OrangeNekoo/HomeFireAlarmSystem/README.md

# 家庭火灾报警系统

基于 TI CC2530（ZB2530 开发板 ×3）的无线传感网课程设计：三个节点组成家庭火灾监测网络，主节点通过 USB 串口桥接 PC，浏览器打开原神风格网页上位机，实时查看温湿度与有害气体数据、下发阈值、触发模拟报警，报警时三端 LED + OLED 联动。

- 平台：CC2530，IAR 8.10，裸机 RF 直连（不用 Z-Stack），自定义帧协议
- 上位机：纯 HTML/CSS/JS + Three.js，`bridge.py` 做串口-WebSocket 桥
- 课程：无线传感网技术课程设计

## 1. 系统架构

```
[温湿度节点 0x02]──RF──┐
                        ├──→ [主节点 0x01] ──USB串口(CSV)──→ [bridge.py] ──WebSocket──→ [网页上位机]
[气体节点 0x03]──RF────┘     LED+OLED报警                    pyserial+WS+静态托管   localhost:8080
```

- RF：250kbps、信道 11（2405MHz，`FREQCTRL=0x0B`）、软件帧内 ID 过滤（`FRMFILT0=0` 关闭硬件过滤，按帧内目的地址字节软件过滤）、广播地址 0xFF；帧尾异或校验防错
- 串口：USART0，115200 8N1，CSV 文本行 + `*校验` 帧尾
- 上位机链路：`bridge.py` HTTP 静态托管 **8080** 端口，WebSocket **8081** 端口
- 报警逻辑集中在主节点：温度 > 阈值（默认 45℃）或气体 ADC 均值 > 阈值（默认 600）即报警，带回差防抖；主节点广播报警状态，终端 OLED 切`火灾警报`（反显+闪烁）+ LED1 闪烁
- 心跳即数据上报（2 秒周期），超 10 秒未收到判定离线；主节点按序号统计丢包率

完整设计见 [docs/superpowers/specs/2026-09-08-home-fire-alarm-design.md](docs/superpowers/specs/2026-09-08-home-fire-alarm-design.md)。

## 2. 硬件清单与接线

| 器件 | 数量 | 用途 |
|---|---|---|
| ZB2530 开发板（CC2530 核心板 + 底板） | 3 | 主节点 / 温湿度节点 / 气体节点 |
| 0.96 寸 OLED（SSD1306，4 线 SPI） | 3 | 三节点显示 |
| DHT11 温湿度传感器 | 1 | 温湿度节点 |
| MQ-2 烟雾/可燃气体模块 | 1 | 气体节点 |
| USB 线（板载 USB 转串口） | 1 | 主节点接 PC |

### 接线表

三节点 OLED 接线统一（4 线软件 SPI，引脚/初始化严格参照 `docs/OLED资料/LCD_OLED示例代码`）：

| OLED 引脚 | CC2530 | 说明 |
|---|---|---|
| SCL（D0） | P1.2 | 软件 SPI 时钟 |
| SDA（D1） | P1.3 | 软件 SPI 数据 |
| RST | P1.7 | 硬件复位（初始化拉低 50ms 再拉高） |
| DC | P0.0 | 命令/数据选通 |
| VCC / GND | 3V3 / GND | |

其余外设：

| 节点 | 外设 | 引脚 | 说明 |
|---|---|---|---|
| 主节点 | 报警 LED | P0.5 输出 | 低电平点亮 |
| 主节点 | 彩蛋按键 | P0.1 输入 | 低电平按下（内部上拉）；按下播放彩蛋动画，再按停止 |
| 主节点 | 串口 | P0.2(RX)/P0.3(TX) | 底板 USB 转串口 |
| 温湿度节点 | DHT11 DATA | P0.7 | 单总线，VCC/GND 按模块标注 |
| 气体节点 | MQ-2 AO | P0.6（AIN6） | ADC 采样 |
| 气体节点 | MQ-2 DO | P0.5 输入 | 开关量（超模块电位器设定值为低） |
| 终端 ×2 | 核心板 LED1 | P1.0 输出 | 报警联动闪烁 |

> **MQ-2 供电安全检查**：若 MQ-2 模块用 5V 供电，AO 输出电压可能超过 CC2530 的 3.3V 耐压。首次使用前先用万用表测清洁空气下的 AO 电压，若超过 3.3V，请在 AO 与 P0.6 之间加 10k/20k 电阻分压。

## 3. 烧录步骤

1. IAR 打开根目录工作区 `HomeFireAlarmSystem.eww`，内含三个工程：`Master`、`TempNode`、`GasNode`。
2. 在 Workspace 下拉框切换工程，分别编译（Project → Rebuild All）。
3. 用 USB 线连接目标板，Project → **Download and Debug**（或 Ctrl+D）烧录，烧完复位运行：
   - `Master` → 主节点（接 PC 的那块）
   - `TempNode` → 温湿度节点
   - `GasNode` → 气体节点

三块板固件独立，互不通用，注意别烧错板子。

> **编码说明**：全部 C 源文件使用 **GBK 编码**（IAR 默认中文编码，注释中文可正常显示）。用 VSCode/Notepad 等外部编辑器查看或修改时请选择 GBK/GB2312 编码打开，**不要用 UTF-8 保存覆盖**，否则 IAR 中中文会变乱码。Python 与网页文件保持 UTF-8 不受影响。

## 4. 启动步骤

1. **MQ-2 预热**：给气体节点上电预热——首次使用 24-48 小时最理想，演示前至少预热 **5 分钟**（否则读数漂移可能误报）。
2. **主节点接 PC**，确认设备管理器里出现串口（如 `COM3`）。
3. **启动桥**（项目自带便携 Python 3.11，不依赖系统 Python；首次使用先装依赖）：

   ```bat
   Python311\python.exe -m pip install pyserial websockets
   Python311\python.exe bridge.py COM3
   ```

   不带参数运行 `bridge.py` 会自动列出可用串口，方便查找 COM 号。
4. **打开上位机**：Edge/Chrome 访问 <http://localhost:8080>。网页自动连接 WebSocket 并自动对时（三块 OLED 的时钟与网页时间一致）。
5. 正常状态：网页显示三张节点卡片、实时温湿度/气体数值与曲线、丢包率；左上串口状态为已连接。若网页连不上硬件，会自动进入**演示模式**（页面有角标提示），重连成功后自动恢复真实数据。

## 5. 答辩演示剧本

前置：三块板烧录最终固件、气体节点预热 ≥5 分钟、主节点 USB 接 PC、`bridge.py` 已启动、网页已打开。

| 步骤 | 操作 | 预期现象 |
|---|---|---|
| 1 正常监测 | 静置观察 | 三卡片在线（金边），数值与曲线滚动，三块 OLED 显示日期时间与数据 |
| 2 阈值报警 | 网页底部"下发阈值"把温度阈值改为 **30**，对着 DHT11 哈气或用热风加热 | 温度超 30 → 三端联动：主节点 LED 闪烁、三块 OLED 切`火灾警报`（反显+闪烁）、网页全屏扩散反应特效；温度回落后**自动解除** |
| 3 模拟报警 | 点网页"模拟报警"按钮 | 三端真实联动，与真实报警效果一致，按钮切换为"解除模拟" |
| 4 解除 | 点"解除模拟"按钮 | 三端恢复正常界面 |
| 5 离线检测 | 拔掉任一终端电源 | 约 10 秒后网页对应卡片变灰"离线"，主节点 OLED 对应数据行显示`离线`；重新上电自动恢复 |
| 6 断线恢复 | 拔主节点 USB（断开串口） | 网页进演示模式并角标提示；重新插回并重启 `bridge.py` 后自动恢复真实数据 |

演示完记得把温度阈值改回默认（45℃）。

### 彩蛋：三端同步动画

主节点 P0.1 接一个低电平按键（另一端接 GND）。在正常监控状态下按下：

1. 主节点去抖确认后经 RF 广播 `cmd=0x04`，并向串口上报 `E,1`；
2. 三块 OLED 同步循环播放 30 帧 64×64 动画（100 ms/帧，居中显示），网页弹出全屏覆盖层播放 30 帧 128×64 动画并循环播放 `web/music/` 下的 MP3；
3. 再次按下 P0.1，三块 OLED 与网页停止播放，OLED 按当前报警状态恢复监控页/报警页，网页复位音乐。

说明：彩蛋与报警状态互相独立，播放期间温湿度/气体采集、上报、离线检测照常；浏览器若拦截自动播放，点击覆盖层中的"启用音乐"按钮即可；网页动画帧位于 `web/easter/128_64/`，固件帧数据由 `tools/extract_easter_frames.py` 从 STM32 工程生成于 `Common/easter_frames.c`（`__code` 存 CODE 区）。

## 6. 常见问题（FAQ）

**串口打开失败 / 被占用**
关掉所有正在占用串口的程序（串口助手、其他 bridge 实例、IAR 的 Terminal I/O），再重新运行 `bridge.py`。

**网页打不开 / 连不上**
- 确认 `bridge.py` 在运行，且用 <http://localhost:8080> 访问（HTTP 8080，WS 8081）；
- 检查 Windows 防火墙是否拦截了 Python，首次运行允许其通过专用网络；
- 端口被占用时换端口或结束占用进程后重启 `bridge.py`。

**RF 收不到数据 / 全部离线**
三块板射频参数必须一致：信道 11（`FREQCTRL=0x0B`，2405MHz）。注意 `FRMFILT0=0` 已关闭硬件帧过滤，收发过滤靠软件按帧内目的 ID 字节判断，SHORT_ADDR 寄存器只是占位——请检查各板天线是否焊好、节点间距不要太远、各 `main.c` 里 `NODE_ID` 与收发帧的 src/dst 配置是否正确（见 `Common/rf.c` 与各 `main.c`）。

**OLED 全黑 / 不亮**
- **RST（P1.7）必须接且初始化时先拉低 50ms 再拉高**——缺失复位沿是屏幕不亮的最常见原因（本次联调实际踩过）；
- 核对四根线：SCL=P1.2、SDA=P1.3、RST=P1.7、DC=P0.0，模块 VCC 接 3V3；
- 电荷泵命令核对：`0x8D 0x14`（开启内部升压，缺失则屏不亮）；

**汉字乱码 / 花屏**
字模为纵向取模、每字 32 字节（上/下半页各 16），来源根目录 `font matrix.txt`；若方向颠倒则整体按位翻转。对照设计规格第 4 节排查。

## 7. 联调记录（待填）

> 本节在三节点硬件联调完成后填写，以下为占位，暂无数据。

- **三节点联调结果**：（硬件联调后填写）
- **MQ-2 阈值标定**：
  - 清洁空气 ADC 均值：（硬件联调后填写）
  - 触发值（酒精/打火机气体逼近时 ADC 均值）：（硬件联调后填写）
  - 最终下发阈值：（硬件联调后填写）
- **发现并修复的问题**：（硬件联调后填写）

## 仓库结构

```
HomeFireAlarmSystem/
├── Master/    主节点 IAR 工程
├── TempNode/  温湿度节点 IAR 工程
├── GasNode/   气体节点 IAR 工程
├── Common/    共享模块（OLED/字库/RF/串口/帧编解码等）
├── Python311/ 便携 Python（不入库，需自备）
├── web/       网页上位机（index.html / main.js / style.css）
├── web/three.min.js  Three.js 渲染库（本地文件，无需 CDN）
├── bridge.py  串口-WebSocket 桥
├── HomeFireAlarmSystem.eww  IAR 工作区
└── docs/      任务书、传感器资料、设计规格
```
