OrangeNekoo/HomeFireAlarmSystem/docs/OLED资料/MinerU_markdown_SPEC_QG-2864TMBEG01_VER_C最新_2097232445432942592.md

# Product Specification

Part Name: OEL Display Module 

Customer Part ID: 

Allvision Part ID: QG-2864TMBEG01 

Ver: C 

## Customer:

Approved by 

From: Allvision technology Inc. 

Approved by 

## Allvision technology Inc.

Http://www.szallvision.com 

## Notes:

1. Please contact Allvision technology Inc.. before assigning your product based on this module specification 2. The information contained herein is presented merely to indicate the characteristics and performance of our products. No responsibility is assumed by Allvision technology Inc. for any intellectual property claims or other problems that may result from application based on the module described herein. 

## Revised History

<table><tr><td>Part Number</td><td>Revision</td><td>Revision Content</td><td>Revised on</td></tr><tr><td>QG-2864TMBEG01</td><td>A</td><td>New</td><td>20130326</td></tr><tr><td></td><td>B</td><td><eq>R_{IREF}=390K</eq>变更为 <eq>R_{IREF}=910K</eq>亮度寄存器(0X81)参数 0XCF 变更为 0X66亮度寄存器(0X81)参数 0X66 变更为 0XCF寄存器(0xD9)的参数 0x1F 变更为 0xF1</td><td>2013052220130529</td></tr></table>

## Contents

Revision History....i
Contents....ii~iii
1. Basic Specifications....1~6
1.1 Display Specifications....1
1.2 Mechanical Specifications....1
1.3 Active Area / Memory Mapping & Pixel Construction....1
1.4 Mechanical Drawing....2
1.5 Pin Definition....3
1.6 Block Diagram....5
1.6.1 Vcc Supplied Externally....5
1.6.2 Vcc Generated by Internal DC/DC Circuit....6
2. Absolute Maximum Ratings....7
3. Optics & Electrical Characteristics....8~18
3.1 Optics Characteristics....8
3.2 DC Characteristics....8
3.3 AC Characteristics....9~18
3.3.1 68XX-Series MPU Parallel Interface Characteristics....9~10
3.3.2 80XX-Series MPU Parallel Interface Characteristics....11~12
3.3.3 Serial Interface Characteristics (4-wire SPI)....13~14
3.3.4 Serial Interface Characteristics (3-wire SPI)....15~16
3.3.5 I²C Interface Characteristics....17~18
4. Functional Specification....19~27
4.1 Commands....19
4.2 Power down and Power up Sequence....19
4.2.1 Power up Sequence....19
4.2.2 Power down Sequence....19
4.3 Reset Circuit....19
4.4 Actual Application Example....20~27
4.4.1 VCC Supplied Externally....20~23
4.4.2 VCC Generated by Internal DC/DC Circuit....24~27
5. Reliability....28
5.1 Contents of Reliability Tests....28
5.2 Failure Check Standard....28
6. Outgoing Quality Control Specifications....29~32
6.1 Environment Required....29
6.2 Sampling Plan....29
6.3 Criteria & Acceptable Quality Level....29~32
6.3.1 Cosmetic Check (Display Off) in Non-Active Area....29~30
6.3.2 Cosmetic Check (Display Off) in Active Area....31
6.3.3 Pattern Check (Display On) in Active Area....32
7. Package Specifications....33
8. Precautions When Using These OEL Display Modules....34~36
8.1 Handling Precautions....34
8.2 Storage Precautions....35
8.3 Designing Precautions....35
8.4 Precautions when disposing of the OEL display modules....35~36 

8.5 Other Precautions.... 36
Warranty.... 36
Notice.... 36 

## 1. Basic Specifications

## 1.1 Display Specifications

1) Display Mode: Passive Matrix 

2) Display Color: Monochrome (Yellow&Blue) 

3) Drive Duty: 

## 1.2 Mechanical Specifications

1) Outline Drawing: According to the annexed outline drawing 

2) Number of Pixels: 128  64 

3) Panel Size: 26.70 × 19.26 × 1.2 (mm) 

4) Active Area: 21.744  11.204 (mm) 

5) Pixel Pitch: 0.17  0.17 (mm) 

6) Pixel Size: 0.154  0.154 (mm) 

7) Weight: 1.54 (g) 

## 1.3 Active Area / Memory Mapping & Pixel Construction





## 1.4 Mechanical Drawing

<table><tr><td>Item</td><td>Date</td><td colspan="8">Remark</td></tr><tr><td>A</td><td>20130326</td><td colspan="8">Original Drawing</td></tr><tr><td>Pin</td><td colspan="9">Symbol</td></tr><tr><td>1</td><td colspan="9">N.C.(GND)</td></tr><tr><td>2</td><td colspan="9">C2P</td></tr><tr><td>3</td><td colspan="9">C2N</td></tr><tr><td>4</td><td colspan="9">C1P</td></tr><tr><td>5</td><td colspan="9">C1N</td></tr><tr><td>6</td><td colspan="9">VBAT</td></tr><tr><td>7</td><td colspan="9">N.C.</td></tr><tr><td>8</td><td colspan="9">VSS</td></tr><tr><td>9</td><td colspan="9">VDD</td></tr><tr><td>10</td><td colspan="9">BS0</td></tr><tr><td>11</td><td colspan="9">BS1</td></tr><tr><td>12</td><td colspan="9">BS2</td></tr><tr><td>13</td><td colspan="9">CS#</td></tr><tr><td>14</td><td colspan="9">RES#</td></tr><tr><td>15</td><td colspan="9">D/C#</td></tr><tr><td>16</td><td colspan="9">R/W#</td></tr><tr><td>17</td><td colspan="9">E/RD#</td></tr><tr><td>18</td><td colspan="9">D0</td></tr><tr><td>19</td><td colspan="9">D1</td></tr><tr><td>20</td><td colspan="9">D2</td></tr><tr><td>21</td><td colspan="9">D3</td></tr><tr><td>22</td><td colspan="9">D4</td></tr><tr><td>23</td><td colspan="9">D5</td></tr><tr><td>24</td><td colspan="9">D6</td></tr><tr><td>25</td><td colspan="9">D7</td></tr><tr><td>26</td><td colspan="9">IREF</td></tr><tr><td>27</td><td colspan="9">VCOMH</td></tr><tr><td>28</td><td colspan="9">VCC</td></tr><tr><td>29</td><td colspan="9">VLSS</td></tr><tr><td>30</td><td colspan="9">N.C.(GND)</td></tr></table>

1.5 Pin Definition

<table><tr><td>Pin Number</td><td>Symbol</td><td>I/O</td><td colspan="4">Function</td></tr><tr><td colspan="7">Power Supply</td></tr><tr><td>9</td><td>VDD</td><td>P</td><td colspan="4">Power Supply for LogicThis is a voltage supply pin. It must be connected to external source.</td></tr><tr><td>8</td><td>VSS</td><td>P</td><td colspan="4">Ground of Logic CircuitThis is a ground pin. It acts as a reference for the logic pins. It must be connected to external ground.</td></tr><tr><td>28</td><td>VCC</td><td>P</td><td colspan="4">Power Supply for OEL PanelThis is the most positive voltage supply pin of the chip. A stabilization capacitor should be connected between this pin and <eq>V_{ss}</eq> when the converter is used. It must be connected to external source when the converter is not used.</td></tr><tr><td>29</td><td>VLSS</td><td>P</td><td colspan="4">Ground of Analog CircuitThis is an analog ground pin. It should be connected to <eq>V_{ss}</eq> externally.</td></tr><tr><td colspan="7">Driver</td></tr><tr><td>26</td><td>IREF</td><td>I</td><td colspan="4">Current Reference for Brightness AdjustmentThis pin is segment current reference pin. A resistor should be connected between this pin and <eq>V_{ss}</eq>. Set the current at 12.5μA maximum.</td></tr><tr><td>27</td><td>VCOMH</td><td>O</td><td colspan="4">Voltage Output High Level for COM SignalThis pin is the input pin for the voltage output high level for COM signals. A capacitor should be connected between this pin and <eq>V_{ss}</eq>.</td></tr><tr><td colspan="7">DC/DC Converter</td></tr><tr><td>6</td><td>VBAT</td><td>P</td><td colspan="4">Power Supply for DC/DC Converter CircuitThis is the power supply pin for the internal buffer of the DC/DC voltage converter. It must be connected to external source when the converter is used. It should be connected to <eq>V_{DD}</eq> when the converter is not used.</td></tr><tr><td>4 / 52 / 3</td><td>C1P / C1NC2P / C2N</td><td>I</td><td colspan="4">Positive Terminal of the Flying Inverting CapacitorNegative Terminal of the Flying Boost CapacitorThe charge-pump capacitors are required between the terminals. They must be floated when the converter is not used.</td></tr><tr><td colspan="7">Interface</td></tr><tr><td rowspan="7">101112</td><td rowspan="7">BS0BS1BS2</td><td rowspan="7">I</td><td colspan="4">Communicating Protocol SelectThese pins are MCU interface selection input. See the following table:</td></tr><tr><td></td><td>BS0</td><td>BS1</td><td>BS2</td></tr><tr><td><eq>I^{2}C</eq></td><td>0</td><td>1</td><td>0</td></tr><tr><td>3-wire SPI</td><td>1</td><td>0</td><td>0</td></tr><tr><td>4-wire SPI</td><td>0</td><td>0</td><td>0</td></tr><tr><td>8-bit 68XX Parallel</td><td>0</td><td>0</td><td>1</td></tr><tr><td>8-bit 80XX Parallel</td><td>0</td><td>1</td><td>1</td></tr><tr><td>14</td><td>RES#</td><td>I</td><td colspan="4">Power Reset for Controller and DriverThis pin is reset signal input. When the pin is low, initialization of the chip is executed. Keep this pin pull high during normal operation.</td></tr><tr><td>13</td><td>CS#</td><td>I</td><td colspan="4">Chip SelectThis pin is the chip select input. The chip is enabled for MCU communication only when CS# is pulled low.</td></tr><tr><td>15</td><td>D/C#</td><td>I</td><td colspan="4">Data/Command ControlThis pin is Data/Command control pin. When the pin is pulled high, the input at D7~D0 is treated as display data. When the pin is pulled low, the input at D7~D0 will be transferred to the command register.When the pin is pulled high and serial interface mode is selected, the data at SDIN will be interpreted as data. When it is pulled low, the data at SDIN will be transferred to the command register. In <eq>I^{2}C</eq> mode, this pin acts as SA0 for slave address selection.For detail relationship to MCU interface signals, please refer to the Timing Characteristics Diagrams.</td></tr><tr><td>17</td><td>E/RD#</td><td>I</td><td colspan="4">Read/Write Enable or ReadThis pin is MCU interface input. When interfacing to a 68XX-series microprocessor, this pin will be used as the Enable (E) signal. Read/write operation is initiated when this pin is pulled high and the CS# is pulled low.When connecting to an 80XX-microprocessor, this pin receives the Read (RD#) signal. Data read operation is initiated when this pin is pulled low and CS# is pulled low.When serial or <eq>I^{2}C</eq> mode is selected, this pin must be connected to <eq>V_{ss}</eq>.</td></tr></table>

1.5 Pin Definition (Continued)

<table><tr><td>Pin Number</td><td>Symbol</td><td>I/O</td><td>Function</td></tr><tr><td colspan="4">Interface (Continued)</td></tr><tr><td>16</td><td>R/W#</td><td>I</td><td>Read/Write Select or WriteThis pin is MCU interface input. When interfacing to a 68XX-series microprocessor, this pin will be used as Read/Write (R/W#) selection input. Pull this pin to &quot;High&quot; for read mode and pull it to &quot;Low&quot; for write mode.When 80XX interface mode is selected, this pin will be the Write (WR#) input.Data write operation is initiated when this pin is pulled low and the CS# is pulled low.When serial or <eq>I^{2}C</eq> mode is selected, this pin must be connected to <eq>V_{SS}</eq>.</td></tr><tr><td>18~25</td><td>D0~D7</td><td>I/O</td><td>Host Data Input/Output BusThese pins are 8-bit bi-directional data bus to be connected to the microprocessor&#x27;s data bus. When serial mode is selected, D1 will be the serial data input SDIN and D0 will be the serial clock input SCLK. When <eq>I^{2}C</eq> mode is selected, D2 &amp; D1 should be tired together and serve as <eq>SDA_{out}</eq> &amp; <eq>SDA_{in}</eq> in application and D0 is the serial clock input SCL.Unused pins must be connected to <eq>V_{SS}</eq> except for D2 in serial mode.</td></tr><tr><td colspan="4">Reserve</td></tr><tr><td>7</td><td>N.C.</td><td>-</td><td>Reserved PinThe N.C. pin between function pins are reserved for compatible and flexible design.</td></tr><tr><td>1, 30</td><td>N.C. (GND)</td><td>-</td><td>Reserved Pin (Supporting Pin)The supporting pins can reduce the influences from stresses on the function pins.These pins must be connected to external ground as the ESD protection circuit.</td></tr></table>

## 1.6 Block Diagram

1.6.1 $\mathsf { V } _ { \mathsf { C C } }$ Supplied Externally 



MCU Interface Selection: BS0, BS1 and BS2 

Pins connected to MCU interface: CS#, RES#, D/C#, R/W#, E/RD#, and D0~D7 

C1, C3: 0.1μF 

C2: 4.7μF 

C4, C5: 4.7μF / 16V X7R 

R1: 910kΩ, R1 = (Voltage at IREF - VSS) / IREF 

1.6.2 $V _ { C C }$ Generated by Internal DC/DC Circuit 



MCU Interface Selection: BS0, BS1 and BS2 

Pins connected to MCU interface: CS#, RES#, D/C#, R/W#, E/RD#, and D0~D7 

C1, C2: 1μF 

C3: $2 . 2 \mu \mathsf { F }$ 

C4: 4.7μF / 16V X7R 

C5, C6: 1μF / 16V X5R 

R1: 910kΩ, R1 = (Voltage at IREF - VSS) / IREF 

## 2. Absolute Maximum Ratings

<table><tr><td>Parameter</td><td>Symbol</td><td>Min</td><td>Max</td><td>Unit</td><td>Notes</td></tr><tr><td>Supply Voltage for Logic</td><td><eq>V_{DD}</eq></td><td>-0.3</td><td>4</td><td>V</td><td>1, 2</td></tr><tr><td>Supply Voltage for Display</td><td><eq>V_{CC}</eq></td><td>0</td><td>16</td><td>V</td><td>1, 2</td></tr><tr><td>Supply Voltage for DC/DC</td><td><eq>V_{BAT}</eq></td><td>-0.3</td><td>5</td><td>V</td><td>1, 2</td></tr><tr><td>Operating Temperature</td><td><eq>T_{OP}</eq></td><td>-40</td><td>85</td><td>°C</td><td></td></tr><tr><td>Storage Temperature</td><td><eq>T_{STG}</eq></td><td>-40</td><td>85</td><td>°C</td><td>3</td></tr><tr><td>Life Time (120 cd/m2)</td><td></td><td>10,000</td><td>-</td><td>hour</td><td>4</td></tr><tr><td>Life Time (80 cd/m2)</td><td></td><td>30,000</td><td>-</td><td>hour</td><td>4</td></tr><tr><td>Life Time (60 cd/m2)</td><td></td><td>50,000</td><td>-</td><td>hour</td><td>4</td></tr></table>

Note 1: All the above voltages are on the basis of $\ " \mathrm { V } _ { \mathsf { S S } } = 0 \mathsf { V } ^ { \prime \prime } .$ 

Note 2: When this module is used beyond the above absolute maximum ratings, permanent breakage of the module may occur. Also, for normal operations, it is desirable to use this module under the conditions according to Section 3. “Optics & Electrical Characteristics”. If this module is used beyond these conditions, malfunctioning of the module can occur and the reliability of the module may deteriorate. 

Note 3: The defined temperature ranges do not include the polarizer. The maximum withstood temperature of the polarizer should be $8 0 \%$ 

Note 4: $\mathsf { V } _ { \mathsf { C C } } = 1 2 . 0 \mathsf { V } , \mathsf { T } _ { \mathsf { a } } = 2 5 ^ { \circ } \mathsf { C } ,$ 50% Checkerboard. 

Software configuration follows Section 4.4 Initialization. 

End of lifetime is specified as 50% of initial brightness reached. The average operating lifetime at room temperature is estimated by the accelerated operation at high temperature conditions. 

## 3. Optics & Electrical Characteristics

## 3.1 Optics Characteristics

<table><tr><td>Characteristics</td><td>Symbol</td><td>Conditions</td><td>Min</td><td>Typ</td><td>Max</td><td>Unit</td></tr><tr><td>Brightness(<eq>V_{CC}</eq> Supplied Externally)</td><td><eq>L_{br}</eq></td><td>Note 5</td><td>150</td><td>-</td><td>-</td><td><eq>cd/m^{2}</eq></td></tr><tr><td>Brightness(<eq>V_{CC}</eq> Generated by Internal DC/DC)</td><td><eq>L_{br}</eq></td><td>Note 6</td><td>150</td><td>180</td><td>-</td><td><eq>cd/m^{2}</eq></td></tr><tr><td>C.I.E. (Blue)</td><td>(x)(y)</td><td>C.I.E. 1931</td><td>0.100.20</td><td>0.140.24</td><td>0.180.28</td><td></td></tr><tr><td>C.I.E. (Yellow)</td><td>(x)(y)</td><td>C.I.E. 1931</td><td>0.430.45</td><td>0.470.49</td><td>0.510.53</td><td></td></tr><tr><td>Dark Room Contrast</td><td>CR</td><td></td><td>-</td><td>2000:1</td><td>-</td><td></td></tr><tr><td>Viewing Angle</td><td></td><td></td><td>-</td><td>Free</td><td>-</td><td>degree</td></tr></table>

* Optical measurement taken at $\mathsf { V } _ { \mathsf { D D } } = 2 . 8 \mathsf { V } ,$ $\mathsf { V } _ { \mathsf { C C } } = 1 2 \mathsf { V }$ & 7<sub>.</sub>25V. 

Software configuration follows Section 4.4 Initialization. 

## 3.2 DC Characteristics

<table><tr><td>Characteristics</td><td>Symbol</td><td>Conditions</td><td>Min</td><td>Typ</td><td>Max</td><td>Unit</td></tr><tr><td>Supply Voltage for Logic</td><td><eq>V_{DD}</eq></td><td></td><td>1.65</td><td>2.8</td><td>3.3</td><td>V</td></tr><tr><td>Supply Voltage for Display (Supplied Externally)</td><td><eq>V_{CC}</eq></td><td>Note 5 (Internal DC/DC Disable)</td><td>11.5</td><td>12.0</td><td>12.5</td><td>V</td></tr><tr><td>Supply Voltage for DC/DC</td><td><eq>V_{BAT}</eq></td><td>Internal DC/DC Enable</td><td>3.5</td><td>-</td><td>4.2</td><td>V</td></tr><tr><td>Supply Voltage for Display (Generated by Internal DC/DC)</td><td><eq>V_{CC}</eq></td><td>Note 6 (Internal DC/DC Enable)</td><td>7.0</td><td>-</td><td>7.5</td><td>V</td></tr><tr><td>High Level Input</td><td><eq>V_{IH}</eq></td><td><eq>I_{OUT} = 100μA, 3.3MHz</eq></td><td><eq>0.8×V_{DD}</eq></td><td>-</td><td><eq>V_{DD}</eq></td><td>V</td></tr><tr><td>Low Level Input</td><td><eq>V_{IL}</eq></td><td><eq>I_{OUT} = 100μA, 3.3MHz</eq></td><td>0</td><td>-</td><td><eq>0.2×V_{DD}</eq></td><td>V</td></tr><tr><td>High Level Output</td><td><eq>V_{OH}</eq></td><td><eq>I_{OUT} = 100μA, 3.3MHz</eq></td><td><eq>0.9×V_{DD}</eq></td><td>-</td><td><eq>V_{DD}</eq></td><td>V</td></tr><tr><td>Low Level Output</td><td><eq>V_{OL}</eq></td><td><eq>I_{OUT} = 100μA, 3.3MHz</eq></td><td>0</td><td>-</td><td><eq>0.1×V_{DD}</eq></td><td>V</td></tr><tr><td>Operating Current for <eq>V_{DD}</eq></td><td><eq>I_{DD}</eq></td><td></td><td>-</td><td>180</td><td>300</td><td>μA</td></tr><tr><td>Operating Current for <eq>V_{CC}</eq>(<eq>V_{CC}</eq> Supplied Externally)</td><td><eq>I_{CC}</eq></td><td>Note 7</td><td>-</td><td>9</td><td>15</td><td>mA</td></tr><tr><td>Operating Current for <eq>V_{BAT}</eq>(<eq>V_{CC}</eq> Generated by Internal DC/DC)</td><td><eq>I_{BAT}</eq></td><td>Note 8</td><td>-</td><td>25.6</td><td>32.0</td><td>mA</td></tr><tr><td>Sleep Mode Current for <eq>V_{DD}</eq></td><td><eq>I_{DD, SLEEP}</eq></td><td></td><td>-</td><td>1</td><td>5</td><td>μA</td></tr><tr><td>Sleep Mode Current for <eq>V_{CC}</eq></td><td><eq>I_{CC, SLEEP}</eq></td><td></td><td>-</td><td>2</td><td>10</td><td>μA</td></tr></table>

Note 5 & 6: Brightness $( \mathsf { L } _ { \mathsf { b r } } )$ and Supply Voltage for Display $( \mathsf { V } _ { \mathsf { C C } } )$ are subject to the change of the pane characteristics and the customer’s request. 

Note 7: V<sub>DD</sub> = 2.8V, V<sub>CC</sub> = 12V, 100% Display Area Turn on. 

Note 8: Vpp = 2.8V, Vcc = 7.25V, 100% Display Area Turn on 

* Software configuration follows Section 4.4 Initialization. 

## 3.3 AC Characteristics

3.3.1.1 68XX-Series MPU Parallel Interface Timing Characteristics:

<table><tr><td>Symbol</td><td>Description</td><td>Min</td><td>Max</td><td>Unit</td></tr><tr><td><eq>t_{cycle}</eq></td><td>Clock Cycle Time</td><td>300</td><td>-</td><td>ns</td></tr><tr><td><eq>t_{AS}</eq></td><td>Address Setup Time</td><td>5</td><td>-</td><td>ns</td></tr><tr><td><eq>t_{AH}</eq></td><td>Address Hold Time</td><td>0</td><td>-</td><td>ns</td></tr><tr><td><eq>t_{DSW}</eq></td><td>Write Data Setup Time</td><td>40</td><td>-</td><td>ns</td></tr><tr><td><eq>t_{DHW}</eq></td><td>Write Data Hold Time</td><td>7</td><td>-</td><td>ns</td></tr><tr><td><eq>t_{DHR}</eq></td><td>Read Data Hold Time</td><td>20</td><td>-</td><td>ns</td></tr><tr><td><eq>t_{OH}</eq></td><td>Output Disable Time</td><td>-</td><td>70</td><td>ns</td></tr><tr><td><eq>t_{ACC}</eq></td><td>Access Time</td><td>-</td><td>140</td><td>ns</td></tr><tr><td rowspan="2"><eq>PW_{CSL}</eq></td><td>Chip Select Low Pulse Width (Read)</td><td>120</td><td rowspan="2">-</td><td rowspan="2">ns</td></tr><tr><td>Chip Select Low Pulse width (Write)</td><td>60</td></tr><tr><td rowspan="2"><eq>PW_{CSH}</eq></td><td>Chip Select High Pulse Width (Read)</td><td>60</td><td rowspan="2">-</td><td rowspan="2">ns</td></tr><tr><td>Chip Select High Pulse Width (Write)</td><td>60</td></tr><tr><td><eq>t_{R}</eq></td><td>Rise Time</td><td>-</td><td>40</td><td>ns</td></tr><tr><td><eq>t_{F}</eq></td><td>Fall Time</td><td>-</td><td>40</td><td>ns</td></tr></table>

* (V<sub>DD</sub> - V<sub>SS</sub> = 1.65V to 3.3V, T<sub>a</sub> = 25°C) 



## 3.3.1.2 68XX-Series MPU Parallel Interface with Internal Charge Pump



Recommended Components: 

C1, C2: 1μF / 16V, X5R 

C3: 2.2μF 

C4: 4.7μF / 16V, X7R 

C5, C6: 1μF 

R1: 910kΩ, R1 = (Voltage at IREF - VSS) / IREF 

R2, R3: 47kΩ 

Q1: FDN338P 

Q2: FDN335N 

Notes: 

VDD: 1.65~3.3V, it should be equal to MPU I/O voltage. 

Vin: 3.5~4.2V 

* VBAT will be connected to VDD when VCC be connected to external source (12V), R1 should be replaced as 910 kΩ. 

3.3.2.1 80XX-Series MPU Parallel Interface Timing Characteristics:

<table><tr><td>Symbol</td><td>Description</td><td>Min</td><td>Max</td><td>Unit</td></tr><tr><td><eq>t_{cycle}</eq></td><td>Clock Cycle Time</td><td>300</td><td>-</td><td>ns</td></tr><tr><td><eq>t_{AS}</eq></td><td>Address Setup Time</td><td>10</td><td>-</td><td>ns</td></tr><tr><td><eq>t_{AH}</eq></td><td>Address Hold Time</td><td>0</td><td>-</td><td>ns</td></tr><tr><td><eq>t_{DSW}</eq></td><td>Write Data Setup Time</td><td>40</td><td>-</td><td>ns</td></tr><tr><td><eq>t_{DHW}</eq></td><td>Write Data Hold Time</td><td>7</td><td>-</td><td>ns</td></tr><tr><td><eq>t_{DHR}</eq></td><td>Read Data Hold Time</td><td>20</td><td>-</td><td>ns</td></tr><tr><td><eq>t_{OH}</eq></td><td>Output Disable Time</td><td>-</td><td>70</td><td>ns</td></tr><tr><td><eq>t_{ACC}</eq></td><td>Access Time</td><td>-</td><td>140</td><td>ns</td></tr><tr><td><eq>t_{PWLR}</eq></td><td>Read Low Time</td><td>120</td><td>-</td><td>ns</td></tr><tr><td><eq>t_{PWLW}</eq></td><td>Write Low Time</td><td>60</td><td>-</td><td>ns</td></tr><tr><td><eq>t_{PWHR}</eq></td><td>Read High Time</td><td>60</td><td>-</td><td>ns</td></tr><tr><td><eq>t_{PWHW}</eq></td><td>Write High Time</td><td>60</td><td>-</td><td>ns</td></tr><tr><td><eq>t_{CS}</eq></td><td>Chip Select Setup Time</td><td>0</td><td>-</td><td>ns</td></tr><tr><td><eq>t_{CSH}</eq></td><td>Chip Select Hold Time to Read Signal</td><td>0</td><td>-</td><td>ns</td></tr><tr><td><eq>t_{CSF}</eq></td><td>Chip Select Hold Time</td><td>20</td><td>-</td><td>ns</td></tr><tr><td><eq>t_{R}</eq></td><td>Rise Time</td><td>-</td><td>40</td><td>ns</td></tr><tr><td><eq>t_{F}</eq></td><td>Fall Time</td><td>-</td><td>40</td><td>ns</td></tr></table>

* (V<sub>DD</sub> - V<sub>SS</sub> = 1.65V to 3.3V, T<sub>a</sub> = 25°C) 



( Read Timin<sub>g</sub> )



( WriteTimin<sub>g</sub> )

## 3.3.2.2 80XX-Series MPU Parallel Interface with Internal Charge Pump

80xx parallel interface



Recommended Components: 

C1, C2: 1μF / 16V, X5R 

C3: 2.2μF 

C4: 4.7μF / 16V, X7R 

C5, C6: 1μF 

R1: 910kΩ, R1 = (Voltage at IREF - VSS) / IREF 

R2, R3: 47kΩ 

Q1: FDN338P 

Q2: FDN335N 

Notes: 

VDD: 1.65~3.3V, it should be equal to MPU I/O voltage. 

Vin: 3.5~4.2V 

* VBAT will be connected to VDD when VCC be connected to external source (12V), R1 should be replaced as 910 kΩ. 

3.3.3.1 Serial Interface Timing Characteristics: (4-wire SPI)

<table><tr><td>Symbol</td><td>Description</td><td>Min</td><td>Max</td><td>Unit</td></tr><tr><td><eq>t_{cycle}</eq></td><td>Clock Cycle Time</td><td>100</td><td>-</td><td>ns</td></tr><tr><td><eq>t_{AS}</eq></td><td>Address Setup Time</td><td>15</td><td>-</td><td>ns</td></tr><tr><td><eq>t_{AH}</eq></td><td>Address Hold Time</td><td>15</td><td>-</td><td>ns</td></tr><tr><td><eq>t_{CSS}</eq></td><td>Chip Select Setup Time</td><td>20</td><td>-</td><td>ns</td></tr><tr><td><eq>t_{CSH}</eq></td><td>Chip Select Hold Time</td><td>10</td><td>-</td><td>ns</td></tr><tr><td><eq>t_{DSW}</eq></td><td>Write Data Setup Time</td><td>15</td><td>-</td><td>ns</td></tr><tr><td><eq>t_{DHW}</eq></td><td>Write Data Hold Time</td><td>15</td><td>-</td><td>ns</td></tr><tr><td><eq>t_{CLKL}</eq></td><td>Clock Low Time</td><td>20</td><td>-</td><td>ns</td></tr><tr><td><eq>t_{CLKH}</eq></td><td>Clock High Time</td><td>20</td><td>-</td><td>ns</td></tr><tr><td><eq>t_{R}</eq></td><td>Rise Time</td><td>-</td><td>40</td><td>ns</td></tr><tr><td><eq>t_{F}</eq></td><td>Fall Time</td><td>-</td><td>40</td><td>ns</td></tr></table>

* (V<sub>DD</sub> - V<sub>SS</sub> = 1.65V to 3.3V, T<sub>a</sub> = 25°C) 





## 3.3.3.2 4-wire Serial Interface with Internal Charge Pump

4-w ire serial interface



Recommended Components: 

C1, C2: 1μF / 16V, X5R 

C3: 2.2μF 

C4: 4.7μF / 16V, X7R 

C5, C6: 1μF 

R1: 910kΩ, R1 = (Voltage at IREF - VSS) / IREF 

R2, R3: 47kΩ 

R4, R5: 4.7kΩ 

Q1: FDN338P 

Q2: FDN335N 

Notes: 

VDD: 1.65~3.3V, it should be equal to MPU I/O voltage. 

Vin: 3.5~4.2V 

* VBAT will be connected to VDD when VCC be connected to external source (12V), R1 should be replaced as 910 kΩ. 

3.3.4.1 Serial Interface Timing Characteristics: (3-wire SPI)

<table><tr><td>Symbol</td><td>Description</td><td>Min</td><td>Max</td><td>Unit</td></tr><tr><td><eq>t_{cycle}</eq></td><td>Clock Cycle Time</td><td>100</td><td>-</td><td>ns</td></tr><tr><td><eq>t_{CSS}</eq></td><td>Chip Select Setup Time</td><td>20</td><td>-</td><td>ns</td></tr><tr><td><eq>t_{CSH}</eq></td><td>Chip Select Hold Time</td><td>10</td><td>-</td><td>ns</td></tr><tr><td><eq>t_{DSW}</eq></td><td>Write Data Setup Time</td><td>15</td><td>-</td><td>ns</td></tr><tr><td><eq>t_{DHW}</eq></td><td>Write Data Hold Time</td><td>15</td><td>-</td><td>ns</td></tr><tr><td><eq>t_{CLKL}</eq></td><td>Clock Low Time</td><td>20</td><td>-</td><td>ns</td></tr><tr><td><eq>t_{CLKH}</eq></td><td>Clock High Time</td><td>20</td><td>-</td><td>ns</td></tr><tr><td><eq>t_{R}</eq></td><td>Rise Time</td><td>-</td><td>40</td><td>ns</td></tr><tr><td><eq>t_{F}</eq></td><td>Fall Time</td><td>-</td><td>40</td><td>ns</td></tr></table>

* (V<sub>DD</sub> - V<sub>SS</sub> = 1.65V to 3.3V, T<sub>a</sub> = 25°C) 





## 3.3.4.2 3-wire Serial Interface with Internal Charge Pump



Recommended Components: 

C1, C2: 1μF / 16V, X5R 

C3: 2.2μF 

C4: 4.7μF / 16V, X7R 

C5, C6: 1μF 

R1: 910kΩ, R1 = (Voltage at IREF - VSS) / IREF 

R2, R3: 47kΩ 

R4, R5: 4.7kΩ 

Q1: FDN338P 

Q2: FDN335N 

Notes: 

VDD: 1.65~3.3V, it should be equal to MPU I/O voltage. 

Vin: 3.5~4.2V 

* VBAT will be connected to VDD when VCC be connected to external source (12V), R1 should be replaced as 910 kΩ. 

## 3.3.5.1 $\bar { \mathsf { I } } ^ { 2 } \mathsf { C }$ Interface Timing Characteristics:

<table><tr><td>Symbol</td><td>Description</td><td>Min</td><td>Max</td><td>Unit</td></tr><tr><td><eq>t_{cycle}</eq></td><td>Clock Cycle Time</td><td>2.5</td><td>-</td><td>μs</td></tr><tr><td><eq>t_{HSTART}</eq></td><td>Start Condition Hold Time</td><td>0.6</td><td>-</td><td>μs</td></tr><tr><td rowspan="2"><eq>t_{HD}</eq></td><td>Data Hold Time (for &quot;SDAOUT&quot; Pin)</td><td>0</td><td rowspan="2">-</td><td rowspan="2">ns</td></tr><tr><td>Data Hold Time (for &quot;SDAIN&quot; Pin)</td><td>300</td></tr><tr><td><eq>t_{SD}</eq></td><td>Data Setup Time</td><td>100</td><td>-</td><td>ns</td></tr><tr><td><eq>t_{SSTART}</eq></td><td>Start Condition Setup Time(Only relevant for a repeated Start condition)</td><td>0.6</td><td>-</td><td>μs</td></tr><tr><td><eq>t_{SSTOP}</eq></td><td>Stop Condition Setup Time</td><td>0.6</td><td>-</td><td>μs</td></tr><tr><td><eq>t_{R}</eq></td><td>Rise Time for Data and Clock Pin</td><td></td><td>300</td><td>ns</td></tr><tr><td><eq>t_{F}</eq></td><td>Fall Time for Data and Clock Pin</td><td></td><td>300</td><td>ns</td></tr><tr><td><eq>t_{IDLE}</eq></td><td>Idle Time before a New Transmission can Start</td><td>1.3</td><td>-</td><td>μs</td></tr></table>

* (V<sub>DD</sub> - V<sub>SS</sub> = 1.65V to 3.3V, T<sub>a</sub> = 25°C) 



I2 C in te rfa c e 

## 3.3.5.2 I<sup>2</sup>C Interface with Internal Charge Pump



## Recommended Components:

C1, C2: 1μF / 16V, X5R 

C3: 2.2μF 

C4: 4.7μF / 16V, X7R 

C5, C6: 1μF 

R1: 910kΩ, R1 = (Voltage at IREF - VSS) / IREF 

R2, R3: 47kΩ 

R4, R5: 4.7kΩ 

Q1: FDN338P 

Q2: FDN335N 

Notes: 

VDD: 1.65~3.3V, it should be equal to MPU I/O voltage. 

Vin: 3.5~4.2V 

The $\bar { \mathsf { I } } ^ { 2 } \mathsf { C }$ slave address is 0111100b’. If the customer ties D/C# (pin 15) to VDD, the $\bar { \mathsf { I } } ^ { 2 } \mathsf { C }$ slave address will be 0111101b’. 

* VBAT will be connected to VDD when VCC be connected to external source (12V), R1 should be replaced as 910 kΩ. 

## 4.Functional Specification

## 4.1 Commands

Refer to the Technical Manual for the SSD1306 

## 4.2 Power down and Power up Sequence

To protect OEL panel and extend the panel life time, the driver IC power up/down routine should include a delay period between high voltage and low voltage power sources during turn on/off. It gives the OEL panel enough time to complete the action of charge and discharge before/after the operation. 

## 4.2.1 Power up Sequence:

1. Power up $\mathsf { V } _ { \mathsf { D D } }$ 

2. Send Display off command 

3. Initialization 

4. Clear Screen 

5. Power up $\mathsf { V } _ { \mathsf { C C } } / \mathsf { V } _ { \mathsf { B A T } }$ 

6. Delay 100ms 

(When $\mathsf { V } _ { \mathsf { C C } }$ is stable) 

7. Send Display on command 



## 4.2.2 Power down Sequence:

1. Send Display off command 

2. Power down $\mathsf { V } _ { \mathsf { C C } } / \mathsf { V } _ { \mathsf { B A T } }$ 

3. Delay 100ms (When $\mathsf { V } _ { \mathsf { C C } } \ / \ \mathsf { V } _ { \mathsf { B A T } }$ is reach 0 and panel is completely discharges) 

4. Power down $\mathsf { V } _ { \mathsf { D D } }$ 



## Note 13:

1) Since an ESD protection circuit is connected between $\mathsf { V } _ { \mathsf { D D } }$ and $\mathsf { V } _ { \mathsf { C C } }$ inside the driver IC, $\mathsf { V } _ { \mathsf { C C } }$ becomes lower than $\mathsf { V } _ { \mathsf { D D } }$ whenever $\mathsf { V } _ { \mathsf { D D } }$ is ON and $\mathsf { V } _ { \mathsf { C C } }$ is OFF. 

2) $\mathsf { V } _ { \mathsf { C C } } / \mathsf { V } _ { \mathsf { B A T } }$ should be kept float (disable) when it is OFF. 

3) Power Pins $( \mathsf { V } _ { \mathsf { D D } } , \mathsf { V } _ { \mathsf { C C } } , \mathsf { V } _ { \mathsf { B A T } } )$ can never be pulled to ground under any circumstance. 

4) $\mathsf { V } _ { \mathsf { D D } }$ should not be power down before $\mathsf { V } _ { \mathsf { C C } } / \mathsf { V } _ { \mathsf { B A T } }$ power down. 

## 4.3 Reset Circuit

When RES# input is low, the chip is initialized with the following status: 

1. Display is OFF 

2. 12864 Display Mode 

3. Normal segment and display data column and row address mapping (SEG0 mapped to column address 00h and COM0 mapped to row address 00h) 

4. Shift register data clear in serial interface 

5. Display start line is set at display RAM address 0 

6. Column address counter is set at 0 

7. Normal scan direction of the COM outputs 

8. Contrast control register is set at 7Fh 

9. Normal display mode (Equivalent to A4h command) 

## 4.4 Actual Application Example

Command usage and explanation of an actual example 

## 4.4.1 V<sub>CC</sub> Supplied Externally

<Power up Sequence> 



If the noise is accidentally occurred at the displaying window during the operation, please reset the display in order to recover the display function.

<Power down Sequence> 

<Entering Sleep Mode> 

<Exiting Sleep Mode> 

write_i(0x00); /*set lower column address*/ write_i(0x10); /*set higher column address*/ 

write_i(0x40); /*set display start line*/ 

write_i(0xB0); /*set page address*/ 

```c
write_i(0x81);    /*contract control*/
write_i(0xcf);    /*128*/

write_i(0xA1);    /*set segment remap*/

write_i(0xA6);    /*normal / reverse*/

write_i(0xA8);    /*multiplex ratio*/
write_i(0x3F);    /*duty = 1/64*/

write_i(0xC8);    /*Com scan direction*/

write_i(0xD3);    /*set display offset*/
write_i(0x00);

write_i(0xD5);    /*set osc division*/
write_i(0x80);

write_i(0xD9);    /*set pre-charge period*/

write_i(0xf1);

write_i(0xDA);    /*set COM pins*/

write_i(0x12);

write_i(0xdb);    /*set vcomh*/

write_i(0x40);

write_i(0x8d);    /*set charge pump disable*/

write_i(0x10);

write_i(0xAF);    /*display ON*/

void write_i(unsigned char ins)
{
    DC=0;
    CS=0;
    WR=1;
    P1=ins;    /*inst*/
    WR=0;
    WR=1;
    CS=1;
}

void write_d(unsigned char dat)
{
    DC=1; 
```

$$
\begin{array}{l} \text {CS = 0;} \\ \text {WR = 1;} \\ \text {P1 = dat;} \\ \text {WR = 0;} \\ \text {WR = 1;} \\ \text {CS = 1;} \\ \} \end{array} \quad / * \text {data*}
$$

```lisp
void delay(unsigned int i)
{
    while(i>0)
    {
    i--;
    }
} 
```

## 4.4.2 Vcc Generated by Internal DC/DC Circuit

## <Power up Sequence>



If the noise is accidentally occurred at the displaying window during the operation, please reset the display in order to recover the display function.

<Power down Sequence> 

<Entering Sleep Mode> 



<Exiting Sleep Mode> 

```c
Internal setting (Charge pump)
{
    RES=1;
    delay(1000);
    RES=0;
    delay(1000);
    RES=1;
    delay(1000);
write_i(0xAE);    /*display off*/
write_i(0x00);    /*set lower column address*/
write_i(0x10);    /*set higher column address*/ 
```

```txt
write_i(0x40);    /*set display start line*/
write_i(0xB0);    /*set page address*/
write_i(0x81);    /*contract control*/
write_i(0xcf);    /*128*/
write_i(0xA1);    /*set segment remap*/
write_i(0xA6);    /*normal / reverse*/
write_i(0xA8);    /*multiplex ratio*/
write_i(0x3F);    /*duty = 1/64*/
write_i(0xC8);    /*Com scan direction*/
write_i(0xD3);    /*set display offset*/
write_i(0x00);
write_i(0xD5);    /*set osc division*/
write_i(0x80);
write_i(0xD9);    /*set pre-charge period*/
write_i(0xf1);
write_i(0xDA);    /*set COM pins*/
write_i(0x12);
write_i(0xdb);    /*set vcomh*/
write_i(0x40);
write_i(0x8d);    /*set charge pump enable*/
write_i(0x14);
write_i(0xAF);    /*display ON*/
}
id write_i(unsigned char ins)
DC=0;
CS=0;
WR=1;
P1=ins;    /*inst*/
WR=0;
WR=1;
CS=1; 
```

void write_d(unsigned char dat) 

```txt
{
    DC=1;
    CS=0;
    WR=1;
    P1=dat;    /*data*/
    WR=0;
    WR=1;
    CS=1;
} 
```

```lisp
void delay(unsigned int i)
{
    while(i>0)
    {
    i--;
    }
} 
```

## 5. Reliability

## 5.1 Contents of Reliability Tests

<table><tr><td>Item</td><td>Conditions</td><td>Criteria</td></tr><tr><td>High Temperature Operation</td><td>70°C, 240 hrs</td><td rowspan="6">The operational functions work.</td></tr><tr><td>Low Temperature Operation</td><td>-40°C, 240 hrs</td></tr><tr><td>High Temperature Storage</td><td>85°C, 240 hrs</td></tr><tr><td>Low Temperature Storage</td><td>-40°C, 240 hrs</td></tr><tr><td>High Temperature/Humidity Operation</td><td>60°C, 90% RH, 120 hrs</td></tr><tr><td>Thermal Shock</td><td>-40°C ⇔ 85°C, 24 cycles60 mins dwell</td></tr></table>

* The samples used for the above tests do not include polarizer. 

* No moisture condensation is observed during tests. 

## 5.2 Failure Check Standard

After the completion of the described reliability test, the samples were left at room temperature for 2 hrs prior to conducting the failure test at $2 3 { \pm } 5 ^ { \circ } \mathsf C ;$ 5515% RH. 

## 6. Outgoing Quality Control Specifications

## 6.1 Environment Required

Customer’s test & measurement are required to be conducted under the following conditions: 

Temperature: 

Humidity: 

23 ± 5℃ 

55  15% RH 

Fluorescent Lamp: 

30W 

Distance between the Panel & Lamp: 

≥ 50cm 

Distance between the Panel & Eyes of the Inspector: ≥ 30cm 

Finger glove (or finger cover) must be worn by the inspector. 

Inspection table or jig must be anti-electrostatic. 

## 6.2 Sampling Plan

Level II, Normal Inspection, Single Sampling, MIL-STD-105E 

## 6.3 Criteria & Acceptable Quality Level

<table><tr><td>Partition</td><td>AQL</td><td>Definition</td></tr><tr><td>Major</td><td>0.65</td><td>Defects in Pattern Check (Display On)</td></tr><tr><td>Minor</td><td>1.0</td><td>Defects in Cosmetic Check (Display Off)</td></tr></table>

## 6.3.1 Cosmetic Check (Display Off) in Non-Active Area

<table><tr><td>Check Item</td><td>Classification</td><td>Criteria</td></tr><tr><td>Panel General Chipping</td><td>Minor</td><td>X &gt; 6 mm (Along with Edge)Y &gt; 1 mm (Perpendicular to edge)</td></tr><tr><td>Panel Crack</td><td>Minor</td><td>Any crack is not allowable.</td></tr><tr><td>Copper Exposed (Even Pin or Film)</td><td>Minor</td><td>Not Allowable by Naked Eye Inspection</td></tr><tr><td>Film or Trace Damage</td><td>Minor</td><td></td></tr><tr><td>Terminal Lead Prober Mark</td><td>Acceptable</td><td></td></tr><tr><td>Glue or Contamination on Pin (Couldn’t Be Removed by Alcohol)</td><td>Minor</td><td></td></tr><tr><td>Ink Marking on Back Side of panel (Exclude on Film)</td><td>Acceptable</td><td>Ignore for Any</td></tr></table>

## 6.3.2 Cosmetic Check (Display Off) in Active Area

It is recommended to execute in clear room environment (class 10k) if actual in necessary.

<table><tr><td>Check Item</td><td>Classification</td><td>Criteria</td></tr><tr><td>Any Dirt &amp; Scratch on Polarizer&#x27;s Protective Film</td><td>Acceptable</td><td>Ignore for not Affect the Polarizer</td></tr><tr><td>Scratches, Fiber, Line-Shape Defect (On Polarizer)</td><td>Minor</td><td>W ≤ 0.1 Ignore W &gt; 0.1 L ≤ 2 n ≤ 1 L &gt; 2 n = 0</td></tr><tr><td>Dirt, Black Spot, Foreign Material, (On Polarizer)</td><td>Minor</td><td>Φ ≤ 0.1 Ignore 0.1 &lt; Φ ≤ 0.25 n ≤ 1 0.25 &lt; Φ n = 0</td></tr><tr><td>Dent, Bubbles, White spot (Any Transparent Spot on Polarizer)</td><td>Minor</td><td>Φ ≤ 0.5 ➔ Ignore if no Influence on Display 0.5 &lt; Φ n = 0 </td></tr><tr><td>Fingerprint, Flow Mark (On Polarizer)</td><td>Minor</td><td>Not Allowable</td></tr></table>

* Protective film should not be tear off when cosmetic check. 

** Definition of W & L & Φ (Unit: mm): Φ = (a + b) / 2 





6.3.3 Pattern Check (Display On) in Active Area

<table><tr><td>Check Item</td><td>Classification</td><td>Criteria</td></tr><tr><td>No Display</td><td>Major</td><td></td></tr><tr><td>Missing Line</td><td>Major</td><td></td></tr><tr><td>Pixel Short</td><td>Major</td><td></td></tr><tr><td>Darker Pixel</td><td>Major</td><td></td></tr><tr><td>Wrong Display</td><td>Major</td><td></td></tr><tr><td>Un-uniform</td><td>Major</td><td></td></tr></table>

## 7. Package Specifications



<table><tr><td colspan="2">Item</td><td colspan="2">Quantity</td></tr><tr><td colspan="2">Module</td><td>810</td><td>per Primary Box</td></tr><tr><td>Holding Trays</td><td>(A)</td><td>15</td><td>per Primary Box</td></tr><tr><td>Total Trays</td><td>(B)</td><td>16</td><td>per Primary Box (Including 1 Empty Tray)</td></tr><tr><td>Primary Box</td><td>(C)</td><td>1~4</td><td>per Carton (4 as Major / Maximum)</td></tr></table>

## 8. Precautions When Using These OEL Display Modules

## 8.1 Handling Precautions

1) Since the display panel is being made of glass, do not apply mechanical impacts such us dropping from a high position. 

2) If the display panel is broken by some accident and the internal organic substance leaks out, be careful not to inhale nor lick the organic substance. 

3) If pressure is applied to the display surface or its neighborhood of the OEL display module, the cell structure may be damaged and be careful not to apply pressure to these sections. 

4) The polarizer covering the surface of the OEL display module is soft and easily scratched. Please be careful when handling the OEL display module. 

5) When the surface of the polarizer of the OEL display module has soil, clean the surface. It takes advantage of by using following adhesion tape. 

* Scotch Mending Tape No. 810 or an equivalent 

Never try to breathe upon the soiled surface nor wipe the surface using cloth containing solvent such as ethyl alcohol, since the surface of the polarizer will become cloudy. 

Also, pay attention that the following liquid and solvent may spoil the polarizer: 

* Water 

* Ketone 

* Aromatic Solvents 

6) Hold OEL display module very carefully when placing OEL display module into the system housing. Do not apply excessive stress or pressure to OEL display module. And, do not over bend the film with electrode pattern layouts. These stresses will influence the display performance. Also, secure sufficient rigidity for the outer cases. 



7) Do not apply stress to the driver IC and the surrounding molded sections. 

8) Do not disassemble nor modify the OEL display module. 

9) Do not apply input signals while the logic power is off. 

10) Pay sufficient attention to the working environments when handing OEL display modules to prevent occurrence of element breakage accidents by static electricity. 

* Be sure to make human body grounding when handling OEL display modules. 

* Be sure to ground tools to use or assembly such as soldering irons. 

* To suppress generation of static electricity, avoid carrying out assembly work under dry environments. 

* Protective film is being applied to the surface of the display panel of the OEL display module. Be careful since static electricity may be generated when exfoliating the protective film. 

11) Protection film is being applied to the surface of the display panel and removes the protection film before assembling it. At this time, if the OEL display module has been stored for a long period of time, residue adhesive material of the protection film may remain on the surface of the display panel after removed of the film. In such case, remove the residue material by the method introduced in the above Section 5). 

12) If electric current is applied when the OEL display module is being dewed or when it is placed under high humidity environments, the electrodes may be corroded and be careful to avoid the above. 

## 8.2 Storage Precautions

1) When storing OEL display modules, put them in static electricity preventive bags avoiding exposure to direct sun light nor to lights of fluorescent lamps. and, also, avoiding high temperature and high humidity environment or low temperature (less than 0C) environments. (We recommend you to store these modules in the packaged state when they were shipped from Allvision technology Inc.) At that time, be careful not to let water drops adhere to the packages or bags nor let dewing occur with them. 

2) If electric current is applied when water drops are adhering to the surface of the OEL display module, when the OEL display module is being dewed or when it is placed under high humidity environments, the electrodes may be corroded and be careful about the above. 

## 8.3 Designing Precautions

1) The absolute maximum ratings are the ratings which cannot be exceeded for OEL display module, and if these values are exceeded, panel damage may be happen. 

2) To prevent occurrence of malfunctioning by noise, pay attention to satisfy the $\mathsf { V } _ { \mathrm { I L } }$ and $\mathsf { V } _ { \mathbb H }$ specifications and, at the same time, to make the signal line cable as short as possible. 

3) We recommend you to install excess current preventive unit (fuses, etc.) to the power circuit $( \mathsf { V } _ { \mathsf { D D } } )$ (Recommend value: 0.5A) 

4) Pay sufficient attention to avoid occurrence of mutual noise interference with the neighboring devices. 

5) As for EMI, take necessary measures on the equipment side basically. 

6) When fastening the OEL display module, fasten the external plastic housing section. 

7) If power supply to the OEL display module is forcibly shut down by such errors as taking out the main battery while the OEL display panel is in operation, we cannot guarantee the quality of this OEL display module. 

8) The electric potential to be connected to the rear face of the IC chip should be as follows: SSD1306 * Connection (contact) to any other potential than the above may lead to rupture of the IC. 

## 8.4 Precautions when disposing of the OEL display modules

1) Request the qualified companies to handle industrial wastes when disposing of the OEL display modules. ${ \sf O r } ,$ when burning them, be sure to observe the environmental and hygienic laws and regulations. 

## 8.5 Other Precautions

1) When an OEL display module is operated for a long of time with fixed pattern may remain as an after image or slight contrast deviation may occur. 

Nonetheless, if the operation is interrupted and left unused for a while, normal state can be restored. Also, there will be no problem in the reliability of the module. 

2) To protect OEL display modules from performance drops by static electricity rapture, etc., do not touch the following sections whenever possible while handling the OEL display modules. * Pins and electrodes 

* Pattern layouts such as the FPC 

3) With this OEL display module, the OEL driver is being exposed. Generally speaking, semiconductor elements change their characteristics when light is radiated according to the principle of the solar battery. Consequently, if this OEL driver is exposed to light, malfunctioning may occur. 

* Design the product and installation method so that the OEL driver may be shielded from light in actual usage. 

* Design the product and installation method so that the OEL driver may be shielded from light during the inspection processes. 

4) Although this OEL display module stores the operation state data by the commands and the indication data, when excessive external noise, etc. enters into the module, the internal status may be changed. It therefore is necessary to take appropriate measures to suppress noise generation or to protect from influences of noise on the system design. 

5) We recommend you to construct its software to make periodical refreshment of the operation statuses (re-setting of the commands and re-transference of the display data) to cope with catastrophic noise. 

## Warranty:

The warranty period shall last twelve (12) months from the date of delivery. Buyer shall be completed to assemble all the processes within the effective twelve (12) months. Allvision technology Inc. shall be liable for replacing any products which contain defective material or process which do not conform to the product specification, applicable drawings and specifications during the warranty period. All products must be preserved, handled and appearance to permit efficient handling during warranty period. The warranty coverage would be exclusive while the returned goods are out of the terms above. 

## Notice:

No part of this material may be reproduces or duplicated in any form or by any means without the written permission of Allvision technology Inc. Allvision technology Inc. reserves the right to make changes to this material without notice. Allvision technology Inc. does not assume any liability of any kind arising out of any inaccuracies contained in this material or due to its application or use in any product or circuit and, further, there is no representation that this material is applicable to products requiring high level reliability, such as, medical products. Moreover, no license to any intellectual property rights is granted by implication or otherwise, and there is no representation or warranty that anything made in accordance with this material will be free from any patent or copyright infringement of a third party. This material or portions thereof may contain technology or the subject relating to strategic products under the control of Foreign Exchange and Foreign Trade Law of Taiwan and may require an export license from the Ministry of International Trade and Industry or other approval from another government agency.
