OrangeNekoo/HomeFireAlarmSystem/docs/superpowers/specs/2026-09-12-easter-egg-animation-design.md

# 彩蛋动画联动功能规格

- 日期：2026-09-12
- 状态：已获用户批准，进入实现阶段
- 关联设计：`docs/superpowers/specs/2026-09-08-home-fire-alarm-design.md`

## 1. 目标

为现有 CC2530 三节点家庭火灾报警系统增加一个独立彩蛋模式：主节点 P0.1 按键按下后，主节点、温湿度节点、气体节点的 OLED 同步循环播放 STM32 示例中的 30 帧动画，网页同时播放 128×64 动画和 `落泪 - DJ小小智.mp3`。再次按下主节点 P0.1 后，三块 OLED 和网页停止彩蛋并恢复正常监控状态。

彩蛋状态与火灾报警状态完全独立。彩蛋播放期间，传感器采集、RF 收发、报警判决、串口数据上报继续运行；停止彩蛋后，显示内容按当时的报警状态恢复。

## 2. 动画资源

### 2.1 固件资源

STM32 工程 `keil/OLEDTest/user/main.c` 中的 `const unsigned char cat[][512]` 是实际播放资源，共 30 帧，每帧 64×64 单色位图、512 字节。格式为逐行存储，每字节横向表示 8 个像素，最高位对应最左像素。数组中的第 5、6 帧注释顺序虽然为 `frame-6`、`frame-5`，但这是原工程的实际播放顺序，移植必须保留该顺序。

生成 `Common/easter_frames.c/.h`，把数组放在程序 Flash 的只读区，不复制到 RAM。OLED 播放时把图像绘制到 128×64 屏幕的 x=32..95、y=0..63 区域，左右 32 列清零。现有 `Common/oled.c` 的 4 线软件 SPI、页寻址和初始化保持不变。

### 2.2 网页资源

将下载目录 `图片素材/128_64/WPS图片批量处理/` 的 30 张 JPG 复制到 `web/easter/128_64/`。网页帧顺序按固件实际播放顺序排列，不能使用字典序直接遍历文件名。将已有 `music/落泪 - DJ小小智.mp3` 复制到 `web/music/`；Finder 元数据文件 `._*.mp3` 不作为资源。

网页使用覆盖层 `<img>` 或 canvas 显示 128×64 帧，按固定 100 ms 帧间隔循环。音乐元素设置 `loop=true`，彩蛋开始时尝试播放，停止时暂停并将 `currentTime` 置零。

## 3. RF 协议

新增命令字 `0x04`：彩蛋状态广播。

```text
帧：AA BB | src | dst=FF | cmd=04 | len=01 | state | xor
state=1：开始或保持播放
state=0：停止并恢复监控
```

主节点按键按下沿切换状态后广播一次。两个从节点收到相同状态时幂等处理：重复的开始帧不重置当前帧号，重复的停止帧不重复重绘。收到新状态后从节点分别在自己的主循环中开始或停止播放，帧间隔为 100 ms。

RF 现有最大载荷 25 字节不变。彩蛋命令不使用报警命令 `0x03`，也不改变 `0x01` 数据上报和 `0x02` 对时语义。

## 4. 主节点按键与状态机

P0.1 配置为普通 GPIO 输入，使用内部上拉配置，按键按下定义为低电平。主循环每 10 ms 采样一次，连续约 30 ms 保持同一电平后确认稳定；仅从稳定释放态转为稳定按下态时切换 `easter_on`，避免长按重复触发。

主节点新增彩蛋状态、当前帧号和下一帧时间。彩蛋开启时主节点直接绘制下一帧，并每 100 ms 绘制后续帧；彩蛋关闭时根据 `alarm_on` 选择报警页或监控页。主节点仍执行 `handle_rf`、`judge_alarm`、离线检测和 CSV 上报。

## 5. 串口与桥接协议

新增上行 CSV：

```text
E,1*校验\r\n  彩蛋开始
E,0*校验\r\n  彩蛋停止
```

`bridge.py.parse_line()` 转换为：

```json
{"type":"easterEgg","on":true}
```

下行协议不新增网页命令，P0.1 是唯一触发源。桥接仍只接受并转发现有 `SET`、`TEST`、`TIME` 命令。

## 6. 从节点行为

TempNode 和 GasNode 各自新增彩蛋状态。播放期间暂停正常 OLED 页面刷新，包括时间、传感器数值和报警页刷新；DHT11、ADC、数据上报、报警 LED、RF 接收仍运行。若彩蛋期间报警状态发生变化，状态变量照常更新但不覆盖动画；停止时根据最新报警状态绘制报警页或正常页面。

## 7. 网页行为

网页收到 `easterEgg` 开始事件时：

1. 保存当前播放状态并显示全屏动画覆盖层。
2. 按 100 ms 定时器显示 30 帧，循环播放。
3. 播放 MP3；若浏览器因自动播放策略拒绝，则显示一次可点击的音乐启用提示，点击后重试。
4. 普通监控数据仍可接收，但不覆盖动画层。

网页收到停止事件时停止定时器、隐藏覆盖层、停止并复位音乐、恢复监控渲染。重复开始/停止事件必须幂等。演示模式也可以通过测试辅助函数注入彩蛋事件，但硬件链路不依赖演示模式。

## 8. 错误处理

- RF 丢失彩蛋状态帧不会阻塞任何节点；下一次主节点按键会再次广播当前新状态。
- 错误 CSV 校验和继续丢弃，不能改变网页彩蛋状态。
- 缺失网页帧或 MP3 时，网页显示动画失败提示但仍允许停止并恢复监控。
- 播放期间不能因传感器数据、报警状态或时钟刷新重置动画帧。
- 彩蛋状态不持久化，任一节点复位后回到正常监控，等待下一次状态广播。

## 9. 验收标准

1. P0.1 一次按下只产生一次 `E,1`，三块 OLED 和网页开始播放；长按不会重复重启动画。
2. 再次按下只产生一次 `E,0`，三块 OLED 和网页停止播放并恢复各自当前状态。
3. RF `0x04` 的开始/停止重复帧幂等，报警命令和传感器上报不受影响。
4. 固件动画为 30 帧 64×64 居中显示，网页为 30 帧 128×64，帧顺序与 STM32 实际数组一致。
5. 网页音乐在允许自动播放时自动开始；被浏览器拦截时可点击恢复，停止时回到开头。
6. Python 逻辑测试通过；三个 IAR 工程 Rebuild 零错误；硬件联调记录真实按键、RF、OLED、网页和音乐现象。
