OrangeNekoo/HomeFireAlarmSystem/docs/OLED资料/MinerU_markdown_UG-2864HSWEG01_Drawing-090120B_2097232481533317120.md

<table><tr><td>Item</td><td>Date</td><td>Remark</td></tr><tr><td>A</td><td>20080910</td><td>Original Drawing</td></tr><tr><td>B</td><td>20090120</td><td>Change FPC &amp; Modify Pin Definition</td></tr></table>



Notes <sub>:</sub> 

1 C<sub>o</sub>l<sub>or:</sub> Whit<sub>e</sub> 

2 Dri<sub>ve</sub>r IC <sub>:</sub> SSD 1 306 

<sub>B</sub>3 . FPC N<sub>um</sub>b<sub>er:</sub> UT-0206-P05 

8-bit 68XX/80XX P<sub>a</sub>r<sub>a</sub>ll<sub>e</sub>l 3 -/4-<sub>w</sub>ir<sub>e</sub> SPI I2C 

5 G<sub>e</sub>n<sub>e</sub>r<sub>a</sub>l T<sub>o</sub>l<sub>e</sub>r<sub>a</sub>n<sub>ce:</sub> ±0 30 

6 The total thickness ( 1 55 Max) is without <sub>p</sub>olarizer <sub>p</sub>rotective film & remove ta<sub>p</sub>e Th<sub>e ac</sub>t<sub>ua</sub>l <sub>assem</sub>bl<sub>e</sub>d t<sub>o</sub>t<sub>a</sub>l thi<sub>c</sub>k<sub>ness w</sub>ith <sub>a</sub>b<sub>ove ma</sub>t<sub>er</sub>i<sub>a</sub>l<sub>s s</sub>h<sub>ou</sub>ld b<sub>e</sub> 1 . 80 M<sub>ax</sub>. 

<table><tr><td>Pin</td><td>Symbol</td></tr><tr><td>1</td><td>N.C. (GND)</td></tr><tr><td>2</td><td>C2P</td></tr><tr><td>3</td><td>C2N</td></tr><tr><td>4</td><td>C1P</td></tr><tr><td>5</td><td>C1N</td></tr><tr><td>6</td><td>VBAT</td></tr><tr><td>7</td><td>N.C.</td></tr><tr><td>8</td><td>VSS</td></tr><tr><td>9</td><td>VDD</td></tr><tr><td>10</td><td>BS0</td></tr><tr><td>11</td><td>BS1</td></tr><tr><td>12</td><td>BS2</td></tr><tr><td>13</td><td>CS#</td></tr><tr><td>14</td><td>RES#</td></tr><tr><td>15</td><td>D/C#</td></tr><tr><td>16</td><td>R/W#</td></tr><tr><td>17</td><td>E/RD#</td></tr><tr><td>18</td><td>D0</td></tr><tr><td>19</td><td>D1</td></tr><tr><td>20</td><td>D2</td></tr><tr><td>21</td><td>D3</td></tr><tr><td>22</td><td>D4</td></tr><tr><td>23</td><td>D5</td></tr><tr><td>24</td><td>D6</td></tr><tr><td>25</td><td>D7</td></tr><tr><td>26</td><td>IREF</td></tr><tr><td>27</td><td>VCOMH</td></tr><tr><td>28</td><td>VCC</td></tr><tr><td>29</td><td>VLSS</td></tr><tr><td>30</td><td>N.C. (GND)</td></tr></table>

<table><tr><td rowspan="2">Customer Approval Signature</td><td rowspan="2" colspan="7">Univision Technology Inc.</td><td colspan="2">Drawing Number</td><td>Rev.</td></tr><tr><td colspan="2">DMX2864SDGF46</td><td>B</td></tr><tr><td rowspan="6"></td><td colspan="2">Unless Otherwise Specified</td><td rowspan="3">Title</td><td rowspan="3" colspan="4">UG-2864HSWEG01 Folding Type OEL Display ModulePixel Number: 128 x 64, Monochrome, COG Package</td><td colspan="3">Material</td></tr><tr><td>Unit</td><td>mm</td><td rowspan="3" colspan="3">Soda Lime / Polyimide</td></tr><tr><td>General Roughness</td><td></td></tr><tr><td colspan="2">Tolerance</td><td></td><td>Drawn</td><td>E.E.</td><td>Panel / E.</td><td>P.M.</td></tr><tr><td>Dimension</td><td>±0.3</td><td>By</td><td>Humphrey Lin</td><td>James Wang</td><td>Ivy Lo</td><td>Cherry Lin</td><td>Scale</td><td>Sheet</td><td>Size</td></tr><tr><td>Angle</td><td>±1</td><td>Date</td><td>20090120</td><td>20090120</td><td>20090120</td><td>20090120</td><td>1:1</td><td>1 of 1</td><td>A3</td></tr></table>
