OrangeNekoo/HomeFireAlarmSystem/Common/easter_frames.c

#include "easter_frames.h"

const unsigned char __code easter_frames[EASTER_FRAME_COUNT][EASTER_FRAME_BYTES] = {

/* frame-1 */
{
    0x00, 0x00, 0x00, 0x00, 0x00, 0x00, 0x00, 0x00, 0x00, 0x00, 0x00, 0x00, 0x00, 0x00, 0x00, 0x00,
    0x00, 0x00, 0x00, 0x00, 0x00, 0x00, 0x00, 0x00, 0x00, 0x00, 0x3c, 0x00, 0x00, 0x00, 0x00, 0x00,
    0x00, 0x00, 0xfe, 0x00, 0x00, 0x00, 0x00, 0x00, 0x00, 0x01, 0xe6, 0x00, 0x00, 0x00, 0x00, 0x00,
    0x00, 0x01, 0xc7, 0x00, 0x00, 0x0f, 0xc0, 0x00, 0x00, 0x03, 0x83, 0x00, 0x00, 0x3f, 0xc0, 0x00,
    0x00, 0x07, 0x03, 0xff, 0xc0, 0xf8, 0xe0, 0x00, 0x00, 0x06, 0x03, 0xff, 0xff, 0xe0, 0xe0, 0x00,
    0x00, 0x0e, 0x00, 0x01, 0xff, 0x80, 0xe0, 0x00, 0x00, 0x0c, 0x00, 0x00, 0x00, 0x00, 0xe0, 0x00,
    0x00, 0x1c, 0x00, 0x00, 0x00, 0x00, 0xc0, 0x00, 0x00, 0x38, 0x00, 0x00, 0x00, 0x00, 0xc0, 0x00,
    0x00, 0x70, 0x00, 0x00, 0x00, 0x00, 0xc0, 0x00, 0x01, 0xe0, 0x00, 0x00, 0x00, 0x00, 0xe0, 0x00,
    0x03, 0xc0, 0x00, 0x00, 0x00, 0x00, 0x60, 0x00, 0x07, 0x80, 0x08, 0x00, 0x00, 0x00, 0x70, 0x00,
    0x0f, 0x00, 0x1c, 0x00, 0x00, 0x00, 0x38, 0x00, 0x0e, 0x00, 0x1c, 0x00, 0x18, 0x00, 0x18, 0x00,
    0x1c, 0x00, 0x1c, 0x00, 0x1c, 0x00, 0x1c, 0x00, 0x00, 0x00, 0x1c, 0x00, 0x3c, 0x00, 0x0e, 0x00,
    0x00, 0x00, 0x1c, 0x80, 0x38, 0x00, 0x06, 0x00, 0x00, 0x00, 0x1f, 0xf0, 0x38, 0x00, 0x07, 0x00,
    0x0e, 0x00, 0x1f, 0x70, 0x38, 0x00, 0x03, 0x80, 0x1c, 0x00, 0x7c, 0x38, 0x38, 0x00, 0x01, 0x80,
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
    0x00, 0xc1, 0xf8, 0x01, 0xdf, 0xc0, 0xe0, 0x00, 0x00, 0xc7, 0xc0, 0x00, 0xfd, 0xf0, 0x00, 0x00,
    0x00, 0xcf, 0x00, 0x00, 0x00, 0x7f, 0x80, 0x00, 0x00, 0xfc, 0x00, 0x00, 0x00, 0x0f, 0x80, 0x00,
    0x00, 0x78, 0x00, 0x00, 0x00, 0x00, 0x00, 0x00, 0x00, 0x00, 0x00, 0x00, 0x00, 0x00, 0x00, 0x00,
}
};
