OrangeNekoo/HomeFireAlarmSystem/docs/OLED资料/LCD_OLED示例代码/codetab.h

/***************************16*16的点阵字体取模方式：共阴——列行式——逆向输出*********/
unsigned char F16x16[] = 	  	 
{ 
/*--  文字:  创  --*/
/*--  宋体12;  此字体下对应的点阵为：宽x高=16x16   --*/
0x20,0x30,0xF8,0xEC,0x67,0x6F,0xFC,0xF8,0x10,0xF8,0xF8,0x00,0xFE,0xFE,0x00,0x00, 
0x00,0x00,0x3F,0x7F,0x60,0x66,0x67,0x73,0x30,0x0F,0x0F,0x60,0x7F,0x3F,0x00,0x00,

/*--  文字:  思  --*/
/*--  宋体12;  此字体下对应的点阵为：宽x高=16x16   --*/
0x00,0x00,0x00,0xFE,0x92,0x92,0x92,0xFE,0x92,0x92,0x92,0x92,0xFE,0x00,0x00,0x00,
0x20,0x38,0x00,0x00,0x3C,0x40,0x40,0x42,0x4C,0x40,0x40,0x70,0x04,0x18,0x30,0x00,

/*--  文字:  通  --*/
/*--  宋体12;  此字体下对应的点阵为：宽x高=16x16   --*/
0x40,0x41,0xC6,0x00,0x00,0xF2,0x52,0x52,0x56,0xFA,0x5A,0x56,0xF2,0x00,0x00,0x00,
0x40,0x20,0x1F,0x20,0x40,0x5F,0x42,0x42,0x42,0x5F,0x4A,0x52,0x4F,0x40,0x40,0x00,

/*--  文字:  信  --*/
/*--  宋体12;  此字体下对应的点阵为：宽x高=16x16   --*/
0x80,0x40,0x30,0xFC,0x07,0x0A,0xA8,0xA8,0xA9,0xAE,0xAA,0xA8,0xA8,0x08,0x08,0x00,
0x00,0x00,0x00,0x7F,0x00,0x00,0x7E,0x22,0x22,0x22,0x22,0x22,0x7E,0x00,0x00,0x00,

/*--  文字:  专  --*/
/*--  宋体12;  此字体下对应的点阵为：宽x高=16x16   --*/
0x20,0x20,0x24,0x24,0xA4,0x64,0x3C,0x27,0x24,0x24,0xA4,0x24,0x24,0x20,0x20,0x00,
0x00,0x00,0x00,0x00,0x01,0x01,0x09,0x11,0x29,0x45,0x03,0x01,0x00,0x00,0x00,0x00,

/*--  文字:  业  --*/
/*--  宋体12;  此字体下对应的点阵为：宽x高=16x16   --*/
0x00,0x10,0x60,0x80,0x00,0xFF,0x00,0x00,0x00,0xFF,0x00,0x80,0x60,0x38,0x10,0x00,
0x20,0x20,0x20,0x23,0x21,0x3F,0x20,0x20,0x20,0x3F,0x22,0x21,0x20,0x30,0x20,0x00,

/*--  文字:  无  --*/
/*--  宋体12;  此字体下对应的点阵为：宽x高=16x16   --*/
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
0x38,0x38,0x38,0x38,0xFF,0x38,0x38,0x38,0x00,0xFF,0x00,0x00,0x00,0xFF,0x00,0x00,
0x00,0x00,0x00,0x08,0xFC,0xFC,0x1E,0x3E,0xFE,0xFE,0xE7,0xE7,0xE3,0xC7,0xCF,0xD9,
0xF1,0xF0,0xF9,0x0C,0x60,0xFF,0xFF,0xDB,0x9B,0x08,0x01,0xFF,0xFF,0xCC,0xEC,0xEE,
0xEE,0xC3,0xFF,0x2D,0x6C,0x76,0x37,0x33,0x13,0xFF,0x7C,0x96,0xD6,0xEB,0x6B,0xE9,
0xFF,0xFF,0xF8,0xF0,0x00,0x00,0x00,0x00,0x00,0x00,0x00,0x00,0x00,0x00,0x00,0x00,
0x00,0x00,0xFF,0xFF,0xC1,0x01,0xFF,0x00,0x00,0x07,0xF8,0x06,0x01,0x01,0xC0,0x00,
0xC0,0xC0,0xC0,0x3F,0x38,0x38,0x00,0x00,0xF8,0x07,0x00,0x00,0x00,0xFF,0x00,0x00,
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
};
