OrangeNekoo/HomeFireAlarmSystem/Common/easter_frames.h

#ifndef EASTER_FRAMES_H
#define EASTER_FRAMES_H

#define EASTER_FRAME_WIDTH 64
#define EASTER_FRAME_HEIGHT 64
#define EASTER_FRAME_BYTES 512
#define EASTER_FRAME_COUNT 30

extern const unsigned char __code easter_frames[EASTER_FRAME_COUNT][EASTER_FRAME_BYTES];

#endif /* EASTER_FRAMES_H */
