OrangeNekoo/HomeFireAlarmSystem/(commit log)

2026-09-08 添加MAC排除
2026-09-08 添加字模
2026-09-08 docs: 添加家庭火灾报警系统设计规格并取消忽略规格目录
2026-09-08 docs: 规格明确bridge.py使用项目内便携Python311环境
2026-09-08 docs: 添加实现计划并修订RF校验与报警命令细节
2026-09-08 docs: OLED驱动改为I2C接口并同步规格与实现计划
2026-09-08 chore: 工程文件移入Master目录
2026-09-09 chore: 重组为三工程workspace并共享Common模块
2026-09-09 chore: 清理DS_Store跟踪并忽略构建产物目录
2026-09-09 feat: 时钟32MHz初始化与T1毫秒时基
2026-09-09 feat: OLED驱动移植与17汉字字库上屏
2026-09-09 feat: RF帧编解码与串口驱动自测通过
2026-09-09 feat: 裸机RF驱动双板互发验证通过
2026-09-09 feat: 温湿度节点DHT11采集上报与RTC走时
2026-09-09 feat: 气体节点ADC滑动平均采样与上报
    - 新增 GasNode/adc.c/h：AIN6(P0.6) 12位ADC采样 + 8点滑动平均滤波
    - main.c 完整实现：预热60s、数据页/报警页、RF上报[seq,adc_hi,adc_lo,do]、对时/联动
    - GasNode.ewp 加入 adc.c；IarBuild 三工程 0 error 0 warning
    - 注：MQ-2 模块 5V 供电时 AO 电压需用户实测确认（>3.3V 则加 10k/20k 分压）
    [adc.c, main.c]
2026-09-09 feat: 主节点界面判决CSV上报与下行指令
2026-09-09 fix: 三节点报警LED改为500ms翻转符合规格
2026-09-09 feat: Python串口桥与单元测试通过
2026-09-09 fix: 桥下行畸形JSON防护防止WS连接中断
2026-09-09 feat: 上位机页面骨架WS与演示模式
2026-09-09 fix: 上位机健壮性搭车修复五项
2026-09-09 feat: 元素核心3D粒子与扩散反应报警特效
2026-09-09 fix: 报警冲击闪改为报警沿触发防止持续重放
2026-09-09 docs: 补充README使用说明
2026-09-09 fix: dht11读取超时与桥/RTC/输入健壮性修复
2026-09-09 chore: 清理构建产物与系统垃圾文件的跟踪
2026-09-09 docs: 修正README帧过滤描述并补全仓库结构
2026-09-09 fix: C源文件编码转换为GBK适配IAR默认中文编码
2026-09-09 chore: 忽略Python缓存与IAR调试器状态文件
2026-09-10 自带python环境
2026-09-10 fix: OLED驱动换回4线SPI并同步文档（RST未拉高是不亮根因）
2026-09-10 fix: 换用新取17字字模修正花屏并改主节点局部刷新消除闪烁
2026-09-10 修改IAR工程配置
2026-09-10 fix: 气体节点预热改倒计时并修复时间疯跳与不同步
    - GasNode 预热期每2s刷新剩余秒数（60→2），结束进主页面时补画时间行
    - 新增 ms_get() 关中断原子读 g_ms：8051 读 u32 撕裂曾致差值下溢、
    追帧逻辑每圈连跳秒（分钟像毫秒疯加）；三节点统一原子取时 +
    卡顿>5s 直接对齐不追帧，双保险
    - 主节点对时广播周期 60s→10s，从节点入网≤10s 即同步
    - 日期分隔符改 -，全模块默认时间 2026-09-10 12:00:00
    [main.c, rtc.c, rtc.h, timer.c, timer.h]
2026-09-10 refactor: 前端按DESIGN.md重构为戴尔1996目录风，bridge加诊断日志
    - 网页全面转向 DESIGN.md（Dell 1996）风格：黑色页框、ribbon 彩卡、
    Arial Black 大字眉标、Times/宋体正文、零圆角零阴影、红色警报CTA
    - 删除旧设计的 3D 元素核心（three.js 舞台/粒子/全屏闪光）及元素感知文案
    - bridge.py 增加逐行收发诊断日志、30s 无串口数据提示、WS 上下行日志，
    便于定位"网页已连接但收不到数据"断在串口还是 RF 链路
    - 忽略 .playwright-cli 临时目录
2026-09-10 修改有害气体模块上电倒计时配置
2026-09-10 fix: CLK_Init 等待时钟切换完全生效，修复系统卡在16M引发的联调问题
    - clk.c：原代码只等 OSC 位生效，切换期间写入的 CLKSPD/TICKSPD=32M
    会被硬件钳回 16M——定时器实际 2ms 一跳（走时慢一半）、串口实际
    57600（bridge 上行全是乱码）、RF 数据率减半（节点全部离线）。
    现改为等待 CLKCONSTA 镜像的 OSC/CLKSPD/TICKSPD 三位全部读回为 0
    - Master：10s 对时节拍增加 S,1,ONLINE 串口心跳行，供 bridge 日志
    诊断串口上行链路（网页端自动忽略 node=1）
    [clk.c, main.c]
2026-09-10 修复波特率计算出错
2026-09-12 fix(数据链路): 修复气体数值倒序与阈值回显
    修正主节点 CSV 数字序列化的重复倒序，保持气体值和三位数阈值的原始顺序。
    移除前端丢包率展示及相关状态处理，并补充协议顺序回归测试。
    [csv.c, test_bridge.py]
2026-09-12 fix(前端报警): 区分真实报警与模拟报警按钮
    真实温度或气体报警时隐藏解除模拟按钮，仅在模拟报警来源为 3 时显示。
    删除网页底部版权、条款和浏览器版本说明，并补充前端回归测试。
    [test_bridge.py]
2026-09-12 feat(彩蛋): 主节点P0.1触发三端同步动画与网页音乐
    - 主节点P0.1去抖按键切换彩蛋，RF广播cmd=0x04并串口上报E,0/E,1
    - 三块OLED播放30帧64×64动画（100ms/帧，居中），停止后按报警状态恢复
    - 15KB帧数组标__code存CODE区，修复XDATA_I链接溢出；删除终端512B复制缓冲
    - bridge解析E消息广播easterEgg JSON；网页覆盖层播放128×64帧并循环MP3
    - 帧提取器tools/extract_easter_frames.py保留原工程第5/6帧交换顺序
    - 新增资源/固件契约/前端/内存契约测试；三IAR工程0错误0警告，浏览器实测通过
    [bridge.py, csv.c, easter_frames.c, easter_frames.h, main.c, oled.c]
2026-09-12 fix(离线检测): 修复T1时基和节点状态更新
    - 修正CC2530 T1CCTL0比较模式与通道中断使能为0x44，恢复g_ms时基\n- 主节点按10秒边界发送从节点OFFLINE并刷新温湿度离线显示\n- 前端以数据新鲜度和S状态渲染ONLINE/OFFLINE，避免演示数据覆盖真实离线状态\n- 增加离线时基、固件显示和前端状态回归测试
    [main.c, test_offline_regression.py, timer.c]
2026-09-12 fix(OLED): 清理离线行残留字符
    - 离线刷新前清空温度和湿度行的旧显存内容\n- 保持温度:离线、湿度:离线格式\n- 增加离线行残留字符回归测试
    [main.c, test_offline_regression.py]
2026-09-12 fix(状态显示): 完善离线全屏刷新和主节点状态栏
    - 从节点离线时主节点统一全屏重绘，清除OLED残留字符\n- 前端维护主节点状态并消费S,1,ONLINE/OFFLINE心跳\n- 增加全屏刷新和主节点状态栏回归测试
    [main.c, test_offline_regression.py]
